islandcontroller/jtag-wire-adapter/doc/3d.png

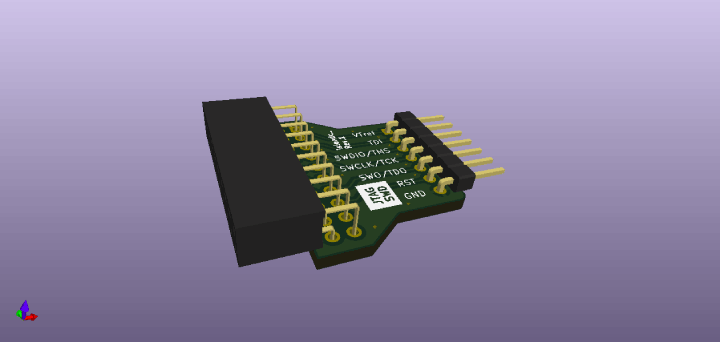
doc/3d.png
