islandcontroller/jtag-wire-adapter/doc/sch_jtag-wire-adapter_rev1.pdf

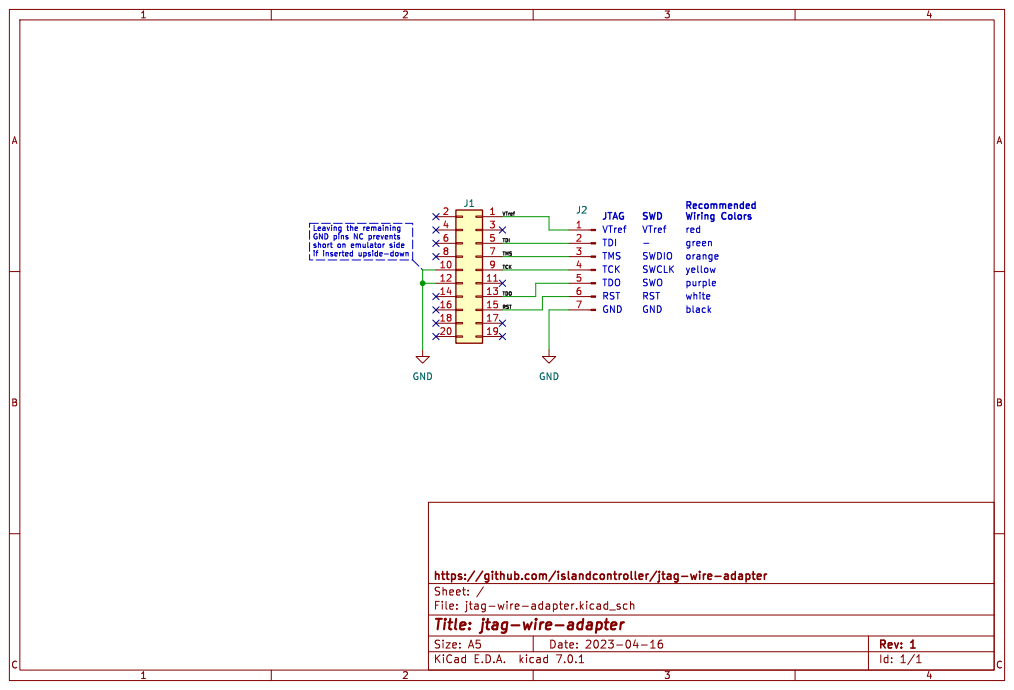
[picture p6: page 1]

Leaving the remaining GND pins NC prevents
