islandcontroller/jtag-wire-adapter/pcb/jtag-wire-adapter.kicad_sch

## KiCad design pcb/jtag-wire-adapter.kicad_sch (2023-04-16)

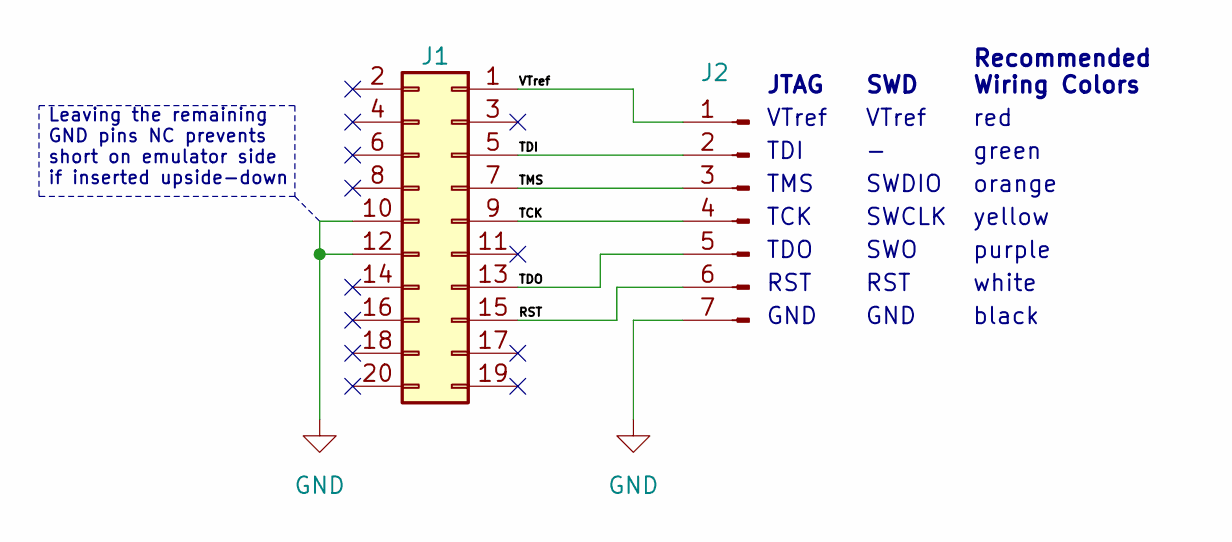
[picture p7: schematic jtag-wire-adapter.kicad_sch]

Parts:
J1: Conn_02x10_Odd_Even; PinSocket_2x10_P2.54mm_Horizontal
J2: Conn_01x07_Pin; PinHeader_1x07_P2.54mm_Horizontal

Connections:
GND: J1.10, J1.12, J2.7
RST: J1.15, J2.6
TCK: J1.9, J2.4
TDI: J1.5, J2.2
TDO: J1.13, J2.5
TMS: J1.7, J2.3
VTref: J1.1, J2.1

Notes on the sheet:
orange
Recommended Wiring Colors
Leaving the remaining GND pins NC prevents short on emulator side if inserted upside-down
SWDIO
black
white
JTAG
SWO
SWCLK
RST
yellow
TMS
TDO
VTref
TCK
GND
TDI
green
purple
red
SWD
