islandcontroller/jtag-wire-adapter/(commit log)

2023-04-16 Added first design iteration
    [jtag-wire-adapter.kicad_pcb, jtag-wire-adapter.kicad_sch]
2023-04-17 Adjusted DRC, layout for prototyping
    [jtag-wire-adapter.kicad_pcb]
2023-04-17 Added SWO label
    [jtag-wire-adapter.kicad_pcb]
2023-04-17 Added PCB preview and 3D render
2023-04-17 Added schematic plot
2023-04-17 Fixed undersize edge-groundplane clearance
    [jtag-wire-adapter.kicad_pcb]
2023-05-04 Added suggested connector part number for J1
