islandcontroller/jtag-wire-adapter/(notices)

Notices in the files:
README.md:
license - CERN-OHL-P-2.0
